ghostwritter91/Soft_Start_Induction_Motor/Photo/1675605165708.jpg

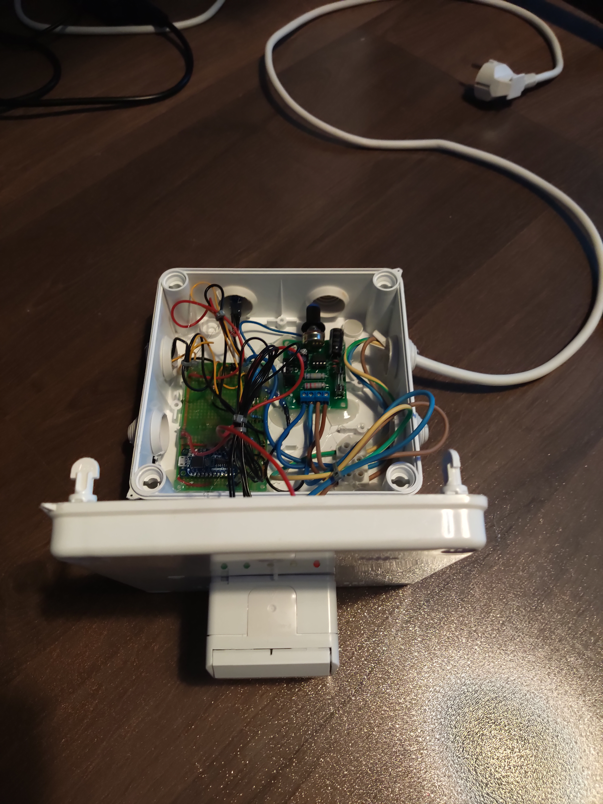
Photo/1675605165708.jpg
