ghostwritter91/Soft_Start_Induction_Motor/README.md

# PCB_Soft_Start_Induction_Motor
Circuit for driving soft start for induction motor 800 W. Device has load detection circuit so it detects when pump is starting and starts launching procedure. Starting procedure is indicated on 5 diodes. Diodes are turned on in sequence from green to red (the more LEDs on, the higher the engine speed). 5 V section provided by USB input (used also for programming) is completly insulated from 230 V by optocouplers.

When motor is of, diodes indicate starting time of motor. There are 5 times to choose (plese see MOTOR_ThresholdsDuration_s 2D array). Time is selected by the potentiometer (knob):
- if one diode is turned on, motor starts slow (knob sets maximum to the left side) - this mode is intended to use when there is no power supply and motor works on UPS supply. 
- when knob is maximum turned to the right side all diodes are turned on - motor starts immediately. Use it for normal operation when pump is powered from standard 230 V power supply.

Device has also trigger button which starts launching sequence - when load detection circuit does not work properly or for tests.

2023-02-05 14_59_31-CN=Microsoft Windows, O=Microsoft Corporation, L=Redmond, S=Washington, C=US

## IDE and EDA
KiCAD 5.1.5 and Microchip studio 7.0

## Hardware
Hardware based on [AVT1007](https://sklep.avt.pl/avt1007.html) and [ATTINY104 XPLAINED NANO EVALUATION KIT](https://www.microchip.com/en-us/development-tool/attiny104-xnano). Potentiometer on AVT1007 is set to minimum (triac almost closed). 10uF capacitor was added in parallel to C3 capacitor. PWM from Attiny104 is used to charge the 10 uF capacitor and change the speed of the motor. U2008 IC has a U/I phases shift compensation and triggering pulse is generated when the voltage on C3 reaches the voltage on C2. Additional potentiometer on AVT1007 kit is used to control the speed of charging C2 capacitor.

Triac on AVT1007 was changed to BTA16-600BW (intended to used with induction load).

obraz

## Knowing issues
- Sometimes when device starts motor again and again, 10 uF capacitor stays charged and motor speed is set to high value. After restart of the device there is no problem.
- There was a problem with an update of the firmware for the debugger on Attiny104 Xplained N board. EPRG_BOOT should be shorted to the GND during power up. After that in device manager drivers for ATmega32U4-MUR should be installed. Microchip Studio then see ATmega32U4-MUR as a USB device and it is possible to update firmware for mEDBG from one of the IDE's folders.
