ghostwritter91/Soft_Start_Induction_Motor/PCB/ATiny104-Xplained.png

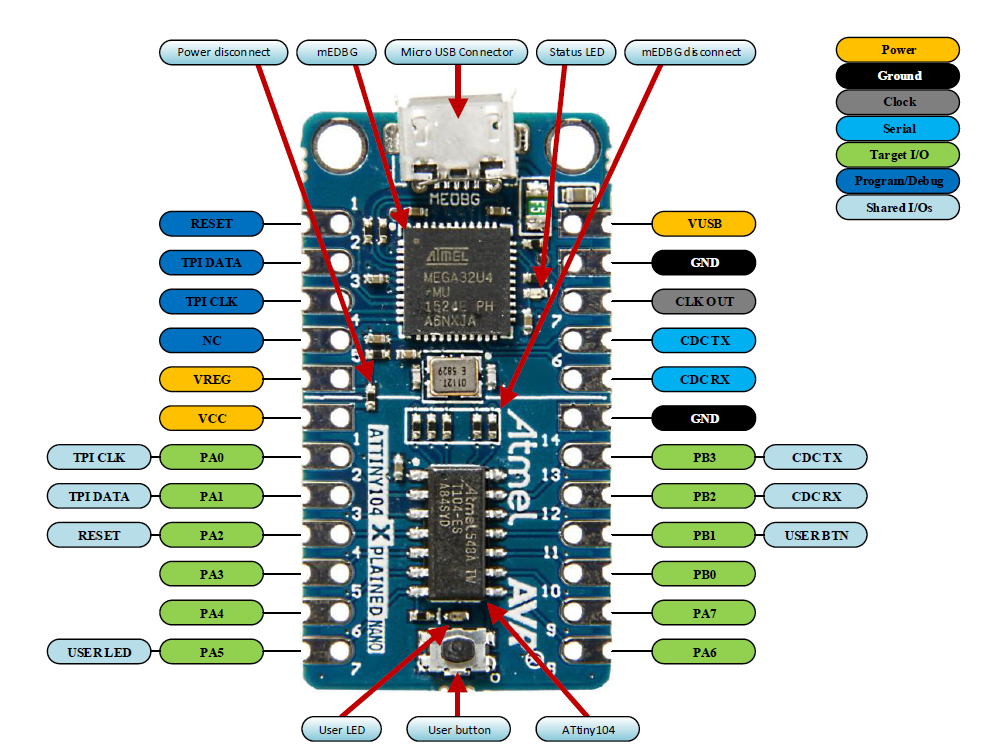
PCB/ATiny104-Xplained.png
