ghostwritter91/Soft_Start_Induction_Motor/PCB/AVT1007.png

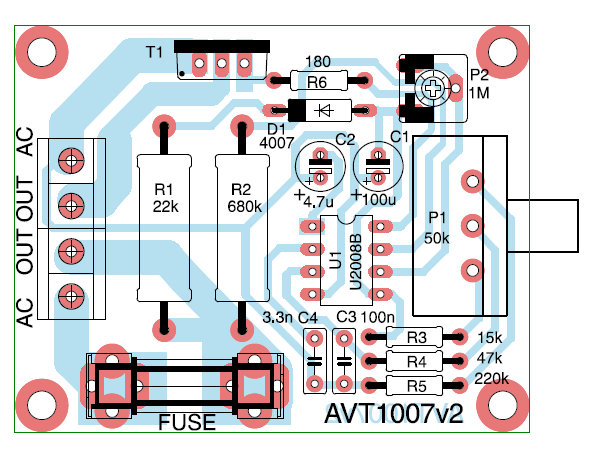
PCB/AVT1007.png
