ghostwritter91/Soft_Start_Induction_Motor/Photo/2023-02-05 14_59_31-CN=Microsoft Windows, O=Microsoft Corporation, L=Redmond, S=Washington, C=US.png

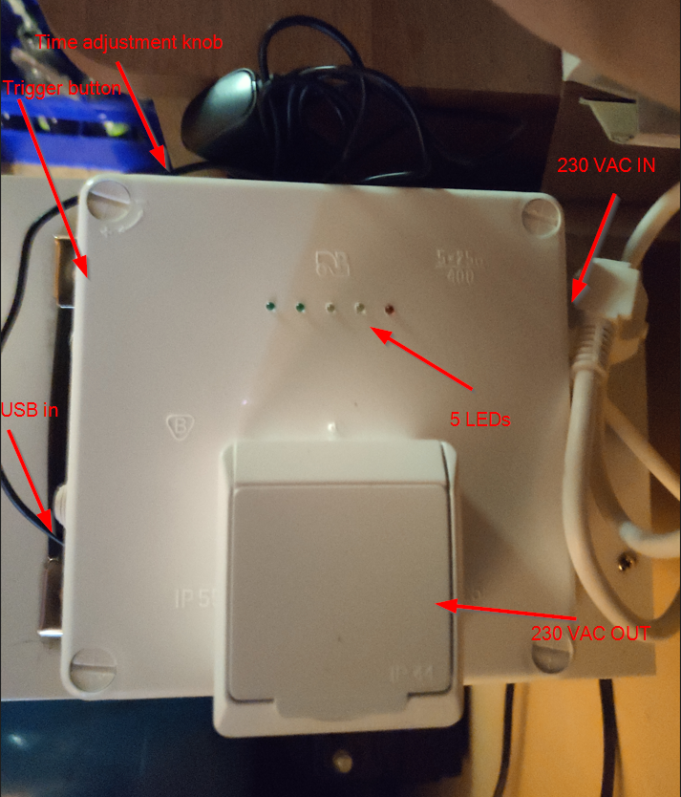
Photo/2023-02-05 14_59_31-CN=Microsoft Windows, O=Microsoft Corporation, L=Redmond, S=Washington, C=US.png
