ghostwritter91/Soft_Start_Induction_Motor/PCB/schematic.pdf

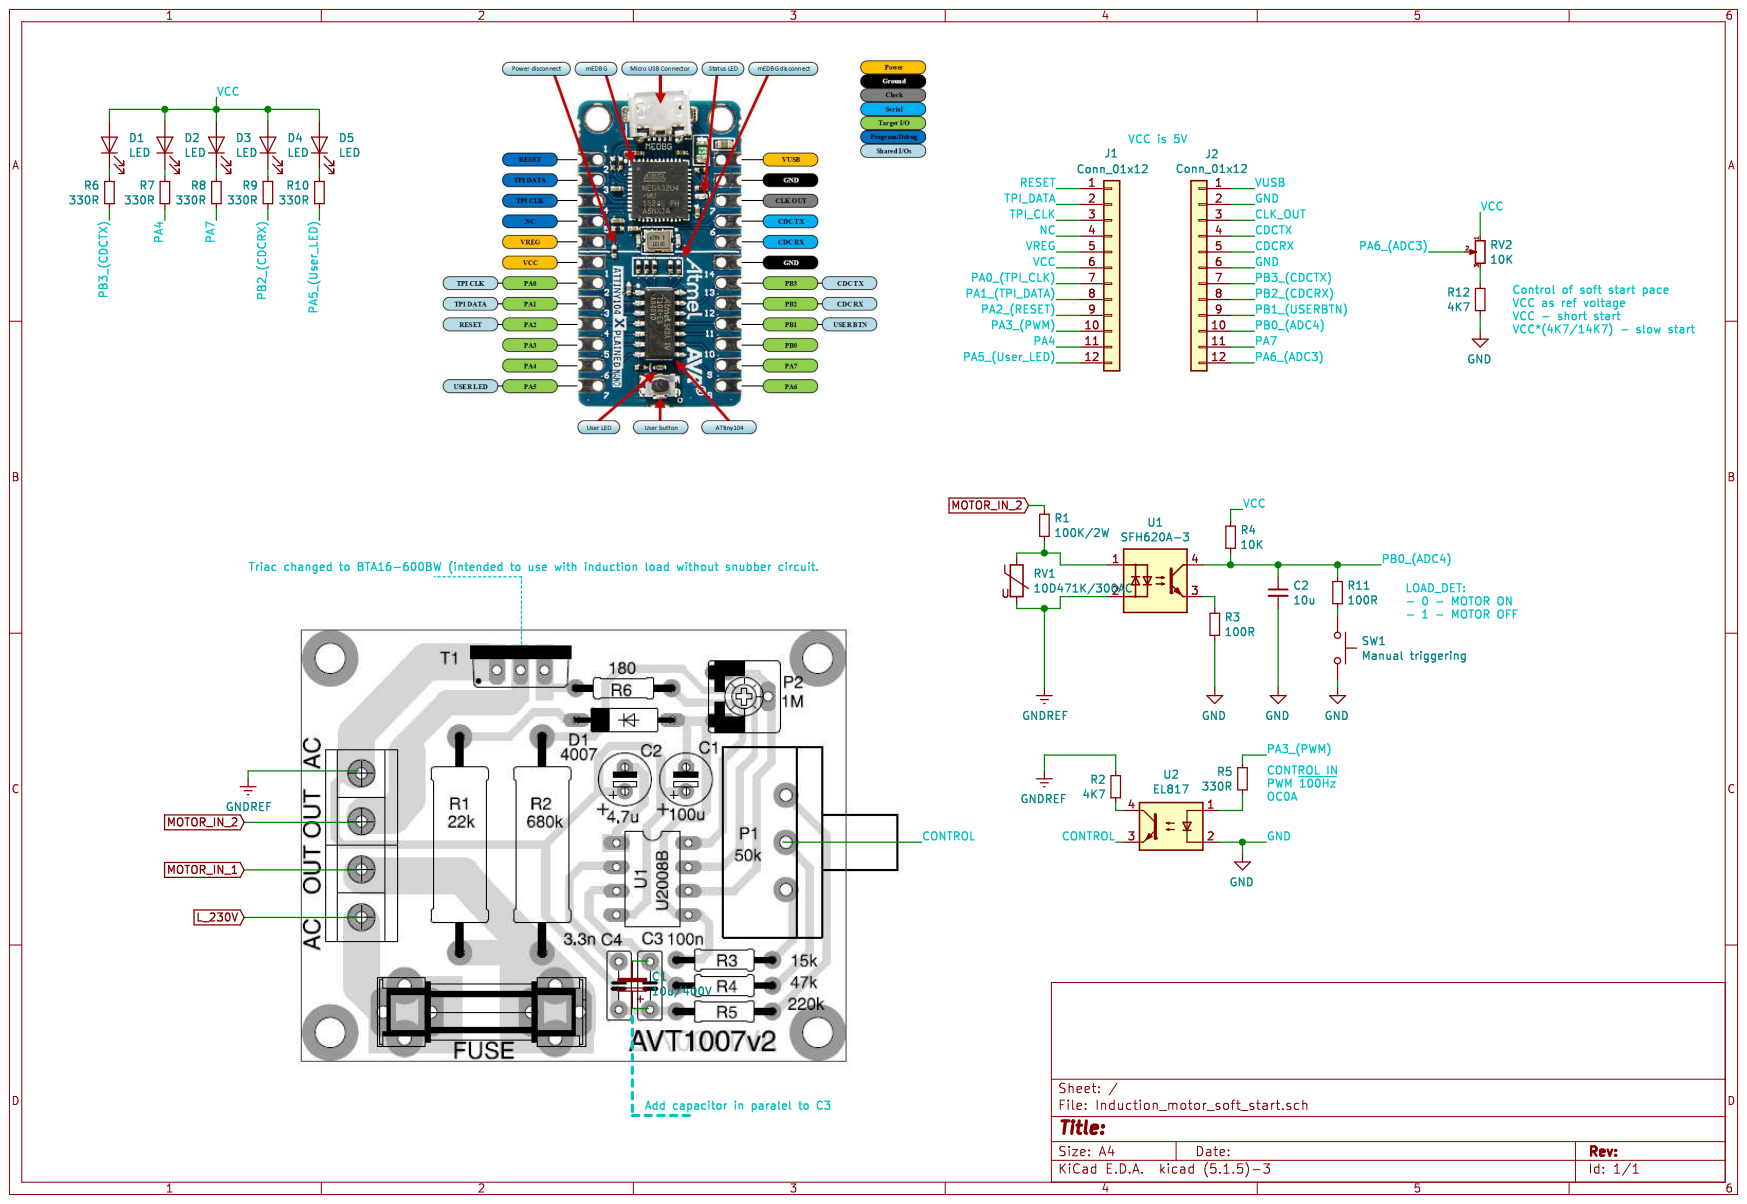
[picture p6: page 1]
