ghostwritter91/Soft_Start_Induction_Motor/LtSpice_Sim/on_off_det.asc

C1: cap; 47n
C2: cap; 16µ
C3: cap; 10µ
L1: ind; 0.35
R1: res; 6.5
R2: res; 100R
R2_2W: res; 100K; pwr=1W
R3: res; 100R
R4: res; 10K
R5: res; 500K
S1: sw; MYSW
U1: SFH620A-3
V1: voltage; SINE(0 324.3 50 1n); Rser=50
V2: voltage; 5v
V3: voltage; PULSE(0 3.3 2m 1u 1u 5s 20s)
Named nets: 0, det
.tran 47s
.model MYSW SW(Ron=0.01 Roff=10Meg Vt=.5 Vh=-.4)
