ghostwritter91/Soft_Start_Induction_Motor/LtSpice_Sim/u2008b.asc

C1: cap; 100µ
C2: cap; 100n
C3: cap; 10µ
D1: diode; 1N4148
R1: res; 330
R2: res; 22K
R3: res; 15K
R4: res; 220K
R5: res; 47K
R6: res; 4K7
U1: PC817A
V1: voltage; SINE(0 324.3 50 0)
V2: voltage; PULSE(0 5 1u 1n 1n 9.9m 10m)
Named nets: 0, CTR
EL817
.tran 30s
0.125W
0.125W
AVT1007
u2008b 3 pin CTR
