ghostwritter91/Soft_Start_Induction_Motor/Soft/Soft_start/Soft_start/src/driver_init.c

/**
 * \file
 *
 * \brief Driver initialization.
 *
 (c) 2020 Microchip Technology Inc. and its subsidiaries.

    Subject to your compliance with these terms,you may use this software and
    any derivatives exclusively with Microchip products.It is your responsibility
    to comply with third party license terms applicable to your use of third party
    software (including open source software) that may accompany Microchip software.

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
    IN NO EVENT WILL MICROCHIP BE LIABLE FOR ANY INDIRECT, SPECIAL, PUNITIVE,
    INCIDENTAL OR CONSEQUENTIAL LOSS, DAMAGE, COST OR EXPENSE OF ANY KIND
    WHATSOEVER RELATED TO THE SOFTWARE, HOWEVER CAUSED, EVEN IF MICROCHIP HAS
    BEEN ADVISED OF THE POSSIBILITY OR THE DAMAGES ARE FORESEEABLE. TO THE
    FULLEST EXTENT ALLOWED BY LAW, MICROCHIP'S TOTAL LIABILITY ON ALL CLAIMS IN
    ANY WAY RELATED TO THIS SOFTWARE WILL NOT EXCEED THE AMOUNT OF FEES, IF ANY,
    THAT YOU HAVE PAID DIRECTLY TO MICROCHIP FOR THIS SOFTWARE.
 *
 */

/*
 * Code generated by START.
 *
 * This file will be overwritten when reconfiguring your START project.
 * Please copy examples or other code you want to keep to a separate file
 * to avoid losing it when reconfiguring.
 */

#include "driver_init.h"
#include <system.h>

/* Configure pins and initialize registers */
void ADC_0_initialization(void)
{

	// Disable pull-up.
	TIME_CNTRL_set_pull_mode(PORT_PULL_OFF);

	// Disable pull-up.
	LOAD_DET_set_pull_mode(PORT_PULL_OFF);

	ADC_0_init();
}

void PWM_0_initialization(void)
{

	PWM_0_init();
}

/**
 * \brief System initialization
 */
void system_init()
{
	mcu_init();

	/* PORT setting on PA3 */

	// Set pin direction to output
	PWM_OUT_set_dir(PORT_DIR_OUT);

	PWM_OUT_set_level(
	    // <y> Initial level
	    // <id> pad_initial_level
	    // <false"> Low
	    // <true"> High
	    false);

	/* PORT setting on PA4 */

	LED_2_set_dir(
	    // <y> Pin direction
	    // <id> pad_dir
	    // <PORT_DIR_OFF"> Off
	    // <PORT_DIR_IN"> In
	    // <PORT_DIR_OUT"> Out
	    PORT_DIR_OUT);

	LED_2_set_level(
	    // <y> Initial level
	    // <id> pad_initial_level
	    // <false"> Low
	    // <true"> High
	    true);

	LED_2_set_pull_mode(
	    // <y> Pull configuration
	    // <id> pad_pull_config
	    // <PORT_PULL_OFF"> Off
	    // <PORT_PULL_UP"> Pull-up
	    PORT_PULL_OFF);

	/* PORT setting on PA5 */

	LED_5_set_dir(
	    // <y> Pin direction
	    // <id> pad_dir
	    // <PORT_DIR_OFF"> Off
	    // <PORT_DIR_IN"> In
	    // <PORT_DIR_OUT"> Out
	    PORT_DIR_OUT);

	LED_5_set_level(
	    // <y> Initial level
	    // <id> pad_initial_level
	    // <false"> Low
	    // <true"> High
	    true);

	LED_5_set_pull_mode(
	    // <y> Pull configuration
	    // <id> pad_pull_config
	    // <PORT_PULL_OFF"> Off
	    // <PORT_PULL_UP"> Pull-up
	    PORT_PULL_OFF);

	/* PORT setting on PA7 */

	LED_3_set_dir(
	    // <y> Pin direction
	    // <id> pad_dir
	    // <PORT_DIR_OFF"> Off
	    // <PORT_DIR_IN"> In
	    // <PORT_DIR_OUT"> Out
	    PORT_DIR_OUT);

	LED_3_set_level(
	    // <y> Initial level
	    // <id> pad_initial_level
	    // <false"> Low
	    // <true"> High
	    true);

	LED_3_set_pull_mode(
	    // <y> Pull configuration
	    // <id> pad_pull_config
	    // <PORT_PULL_OFF"> Off
	    // <PORT_PULL_UP"> Pull-up
	    PORT_PULL_OFF);

	/* PORT setting on PB2 */

	LED_4_set_dir(
	    // <y> Pin direction
	    // <id> pad_dir
	    // <PORT_DIR_OFF"> Off
	    // <PORT_DIR_IN"> In
	    // <PORT_DIR_OUT"> Out
	    PORT_DIR_OUT);

	LED_4_set_level(
	    // <y> Initial level
	    // <id> pad_initial_level
	    // <false"> Low
	    // <true"> High
	    true);

	LED_4_set_pull_mode(
	    // <y> Pull configuration
	    // <id> pad_pull_config
	    // <PORT_PULL_OFF"> Off
	    // <PORT_PULL_UP"> Pull-up
	    PORT_PULL_OFF);

	/* PORT setting on PB3 */

	LED_1_set_dir(
	    // <y> Pin direction
	    // <id> pad_dir
	    // <PORT_DIR_OFF"> Off
	    // <PORT_DIR_IN"> In
	    // <PORT_DIR_OUT"> Out
	    PORT_DIR_OUT);

	LED_1_set_level(
	    // <y> Initial level
	    // <id> pad_initial_level
	    // <false"> Low
	    // <true"> High
	    true);

	LED_1_set_pull_mode(
	    // <y> Pull configuration
	    // <id> pad_pull_config
	    // <PORT_PULL_OFF"> Off
	    // <PORT_PULL_UP"> Pull-up
	    PORT_PULL_OFF);

	sysctrl_init();

	ADC_0_initialization();

	PWM_0_initialization();
}
