ghostwritter91/Soft_Start_Induction_Motor/Soft/Soft_start/Soft_start/include/atmel_start_pins.h

/*
 * Code generated from Atmel Start.
 *
 * This file will be overwritten when reconfiguring your Atmel Start project.
 * Please copy examples or other code you want to keep to a separate file
 * to avoid losing it when reconfiguring.
 */
#ifndef ATMEL_START_PINS_H_INCLUDED
#define ATMEL_START_PINS_H_INCLUDED

#include <port.h>

/**
 * \brief Set PWM_OUT pull mode
 *
 * Configure pin to pull up, down or disable pull mode, supported pull
 * modes are defined by device used
 *
 * \param[in] pull_mode Pin pull mode
 */
static inline void PWM_OUT_set_pull_mode(const enum port_pull_mode pull_mode)
{
	PORTA_set_pin_pull_mode(3, pull_mode);
}

/**
 * \brief Set PWM_OUT data direction
 *
 * Select if the pin data direction is input, output or disabled.
 * If disabled state is not possible, this function throws an assert.
 *
 * \param[in] direction PORT_DIR_IN  = Data direction in
 *                      PORT_DIR_OUT = Data direction out
 *                      PORT_DIR_OFF = Disables the pin
 *                      (low power state)
 */
static inline void PWM_OUT_set_dir(const enum port_dir dir)
{
	PORTA_set_pin_dir(3, dir);
}

/**
 * \brief Set PWM_OUT level
 *
 * Sets output level on a pin
 *
 * \param[in] level true  = Pin level set to "high" state
 *                  false = Pin level set to "low" state
 */
static inline void PWM_OUT_set_level(const bool level)
{
	PORTA_set_pin_level(3, level);
}

/**
 * \brief Toggle output level on PWM_OUT
 *
 * Toggle the pin level
 */
static inline void PWM_OUT_toggle_level()
{
	PORTA_toggle_pin_level(3);
}

/**
 * \brief Get level on PWM_OUT
 *
 * Reads the level on a pin
 */
static inline bool PWM_OUT_get_level()
{
	return PORTA_get_pin_level(3);
}

/**
 * \brief Set LED_2 pull mode
 *
 * Configure pin to pull up, down or disable pull mode, supported pull
 * modes are defined by device used
 *
 * \param[in] pull_mode Pin pull mode
 */
static inline void LED_2_set_pull_mode(const enum port_pull_mode pull_mode)
{
	PORTA_set_pin_pull_mode(4, pull_mode);
}

/**
 * \brief Set LED_2 data direction
 *
 * Select if the pin data direction is input, output or disabled.
 * If disabled state is not possible, this function throws an assert.
 *
 * \param[in] direction PORT_DIR_IN  = Data direction in
 *                      PORT_DIR_OUT = Data direction out
 *                      PORT_DIR_OFF = Disables the pin
 *                      (low power state)
 */
static inline void LED_2_set_dir(const enum port_dir dir)
{
	PORTA_set_pin_dir(4, dir);
}

/**
 * \brief Set LED_2 level
 *
 * Sets output level on a pin
 *
 * \param[in] level true  = Pin level set to "high" state
 *                  false = Pin level set to "low" state
 */
static inline void LED_2_set_level(const bool level)
{
	PORTA_set_pin_level(4, level);
}

/**
 * \brief Toggle output level on LED_2
 *
 * Toggle the pin level
 */
static inline void LED_2_toggle_level()
{
	PORTA_toggle_pin_level(4);
}

/**
 * \brief Get level on LED_2
 *
 * Reads the level on a pin
 */
static inline bool LED_2_get_level()
{
	return PORTA_get_pin_level(4);
}

/**
 * \brief Set LED_5 pull mode
 *
 * Configure pin to pull up, down or disable pull mode, supported pull
 * modes are defined by device used
 *
 * \param[in] pull_mode Pin pull mode
 */
static inline void LED_5_set_pull_mode(const enum port_pull_mode pull_mode)
{
	PORTA_set_pin_pull_mode(5, pull_mode);
}

/**
 * \brief Set LED_5 data direction
 *
 * Select if the pin data direction is input, output or disabled.
 * If disabled state is not possible, this function throws an assert.
 *
 * \param[in] direction PORT_DIR_IN  = Data direction in
 *                      PORT_DIR_OUT = Data direction out
 *                      PORT_DIR_OFF = Disables the pin
 *                      (low power state)
 */
static inline void LED_5_set_dir(const enum port_dir dir)
{
	PORTA_set_pin_dir(5, dir);
}

/**
 * \brief Set LED_5 level
 *
 * Sets output level on a pin
 *
 * \param[in] level true  = Pin level set to "high" state
 *                  false = Pin level set to "low" state
 */
static inline void LED_5_set_level(const bool level)
{
	PORTA_set_pin_level(5, level);
}

/**
 * \brief Toggle output level on LED_5
 *
 * Toggle the pin level
 */
static inline void LED_5_toggle_level()
{
	PORTA_toggle_pin_level(5);
}

/**
 * \brief Get level on LED_5
 *
 * Reads the level on a pin
 */
static inline bool LED_5_get_level()
{
	return PORTA_get_pin_level(5);
}

/**
 * \brief Set TIME_CNTRL pull mode
 *
 * Configure pin to pull up, down or disable pull mode, supported pull
 * modes are defined by device used
 *
 * \param[in] pull_mode Pin pull mode
 */
static inline void TIME_CNTRL_set_pull_mode(const enum port_pull_mode pull_mode)
{
	PORTA_set_pin_pull_mode(6, pull_mode);
}

/**
 * \brief Set TIME_CNTRL data direction
 *
 * Select if the pin data direction is input, output or disabled.
 * If disabled state is not possible, this function throws an assert.
 *
 * \param[in] direction PORT_DIR_IN  = Data direction in
 *                      PORT_DIR_OUT = Data direction out
 *                      PORT_DIR_OFF = Disables the pin
 *                      (low power state)
 */
static inline void TIME_CNTRL_set_dir(const enum port_dir dir)
{
	PORTA_set_pin_dir(6, dir);
}

/**
 * \brief Set TIME_CNTRL level
 *
 * Sets output level on a pin
 *
 * \param[in] level true  = Pin level set to "high" state
 *                  false = Pin level set to "low" state
 */
static inline void TIME_CNTRL_set_level(const bool level)
{
	PORTA_set_pin_level(6, level);
}

/**
 * \brief Toggle output level on TIME_CNTRL
 *
 * Toggle the pin level
 */
static inline void TIME_CNTRL_toggle_level()
{
	PORTA_toggle_pin_level(6);
}

/**
 * \brief Get level on TIME_CNTRL
 *
 * Reads the level on a pin
 */
static inline bool TIME_CNTRL_get_level()
{
	return PORTA_get_pin_level(6);
}

/**
 * \brief Set LED_3 pull mode
 *
 * Configure pin to pull up, down or disable pull mode, supported pull
 * modes are defined by device used
 *
 * \param[in] pull_mode Pin pull mode
 */
static inline void LED_3_set_pull_mode(const enum port_pull_mode pull_mode)
{
	PORTA_set_pin_pull_mode(7, pull_mode);
}

/**
 * \brief Set LED_3 data direction
 *
 * Select if the pin data direction is input, output or disabled.
 * If disabled state is not possible, this function throws an assert.
 *
 * \param[in] direction PORT_DIR_IN  = Data direction in
 *                      PORT_DIR_OUT = Data direction out
 *                      PORT_DIR_OFF = Disables the pin
 *                      (low power state)
 */
static inline void LED_3_set_dir(const enum port_dir dir)
{
	PORTA_set_pin_dir(7, dir);
}

/**
 * \brief Set LED_3 level
 *
 * Sets output level on a pin
 *
 * \param[in] level true  = Pin level set to "high" state
 *                  false = Pin level set to "low" state
 */
static inline void LED_3_set_level(const bool level)
{
	PORTA_set_pin_level(7, level);
}

/**
 * \brief Toggle output level on LED_3
 *
 * Toggle the pin level
 */
static inline void LED_3_toggle_level()
{
	PORTA_toggle_pin_level(7);
}

/**
 * \brief Get level on LED_3
 *
 * Reads the level on a pin
 */
static inline bool LED_3_get_level()
{
	return PORTA_get_pin_level(7);
}

/**
 * \brief Set LOAD_DET pull mode
 *
 * Configure pin to pull up, down or disable pull mode, supported pull
 * modes are defined by device used
 *
 * \param[in] pull_mode Pin pull mode
 */
static inline void LOAD_DET_set_pull_mode(const enum port_pull_mode pull_mode)
{
	PORTB_set_pin_pull_mode(0, pull_mode);
}

/**
 * \brief Set LOAD_DET data direction
 *
 * Select if the pin data direction is input, output or disabled.
 * If disabled state is not possible, this function throws an assert.
 *
 * \param[in] direction PORT_DIR_IN  = Data direction in
 *                      PORT_DIR_OUT = Data direction out
 *                      PORT_DIR_OFF = Disables the pin
 *                      (low power state)
 */
static inline void LOAD_DET_set_dir(const enum port_dir dir)
{
	PORTB_set_pin_dir(0, dir);
}

/**
 * \brief Set LOAD_DET level
 *
 * Sets output level on a pin
 *
 * \param[in] level true  = Pin level set to "high" state
 *                  false = Pin level set to "low" state
 */
static inline void LOAD_DET_set_level(const bool level)
{
	PORTB_set_pin_level(0, level);
}

/**
 * \brief Toggle output level on LOAD_DET
 *
 * Toggle the pin level
 */
static inline void LOAD_DET_toggle_level()
{
	PORTB_toggle_pin_level(0);
}

/**
 * \brief Get level on LOAD_DET
 *
 * Reads the level on a pin
 */
static inline bool LOAD_DET_get_level()
{
	return PORTB_get_pin_level(0);
}

/**
 * \brief Set LED_4 pull mode
 *
 * Configure pin to pull up, down or disable pull mode, supported pull
 * modes are defined by device used
 *
 * \param[in] pull_mode Pin pull mode
 */
static inline void LED_4_set_pull_mode(const enum port_pull_mode pull_mode)
{
	PORTB_set_pin_pull_mode(2, pull_mode);
}

/**
 * \brief Set LED_4 data direction
 *
 * Select if the pin data direction is input, output or disabled.
 * If disabled state is not possible, this function throws an assert.
 *
 * \param[in] direction PORT_DIR_IN  = Data direction in
 *                      PORT_DIR_OUT = Data direction out
 *                      PORT_DIR_OFF = Disables the pin
 *                      (low power state)
 */
static inline void LED_4_set_dir(const enum port_dir dir)
{
	PORTB_set_pin_dir(2, dir);
}

/**
 * \brief Set LED_4 level
 *
 * Sets output level on a pin
 *
 * \param[in] level true  = Pin level set to "high" state
 *                  false = Pin level set to "low" state
 */
static inline void LED_4_set_level(const bool level)
{
	PORTB_set_pin_level(2, level);
}

/**
 * \brief Toggle output level on LED_4
 *
 * Toggle the pin level
 */
static inline void LED_4_toggle_level()
{
	PORTB_toggle_pin_level(2);
}

/**
 * \brief Get level on LED_4
 *
 * Reads the level on a pin
 */
static inline bool LED_4_get_level()
{
	return PORTB_get_pin_level(2);
}

/**
 * \brief Set LED_1 pull mode
 *
 * Configure pin to pull up, down or disable pull mode, supported pull
 * modes are defined by device used
 *
 * \param[in] pull_mode Pin pull mode
 */
static inline void LED_1_set_pull_mode(const enum port_pull_mode pull_mode)
{
	PORTB_set_pin_pull_mode(3, pull_mode);
}

/**
 * \brief Set LED_1 data direction
 *
 * Select if the pin data direction is input, output or disabled.
 * If disabled state is not possible, this function throws an assert.
 *
 * \param[in] direction PORT_DIR_IN  = Data direction in
 *                      PORT_DIR_OUT = Data direction out
 *                      PORT_DIR_OFF = Disables the pin
 *                      (low power state)
 */
static inline void LED_1_set_dir(const enum port_dir dir)
{
	PORTB_set_pin_dir(3, dir);
}

/**
 * \brief Set LED_1 level
 *
 * Sets output level on a pin
 *
 * \param[in] level true  = Pin level set to "high" state
 *                  false = Pin level set to "low" state
 */
static inline void LED_1_set_level(const bool level)
{
	PORTB_set_pin_level(3, level);
}

/**
 * \brief Toggle output level on LED_1
 *
 * Toggle the pin level
 */
static inline void LED_1_toggle_level()
{
	PORTB_toggle_pin_level(3);
}

/**
 * \brief Get level on LED_1
 *
 * Reads the level on a pin
 */
static inline bool LED_1_get_level()
{
	return PORTB_get_pin_level(3);
}

#endif /* ATMEL_START_PINS_H_INCLUDED */
