ghostwritter91/Soft_Start_Induction_Motor/(commit log)

2023-01-27 Init connection schematic
    [BOM.csv, BOM.xls, Induction_motor_soft_start.kicad_pcb, Induction_motor_soft_start.sch]
2023-02-05 Put software PCB and sim to one repo
    [BOM.csv, BOM.xls, Induction_motor_soft_start.kicad_pcb, Induction_motor_soft_start.sch]
2023-02-05 Add schematic saved to pdf
2023-02-05 Add device photos
2023-02-05 Add info about triac
    [Induction_motor_soft_start.sch]
